SverreOK/fdcanhat/fdcanhat/fdcanhat.kicad_pcb

## KiCad design fdcanhat/fdcanhat.kicad_pcb (2026-01-27)

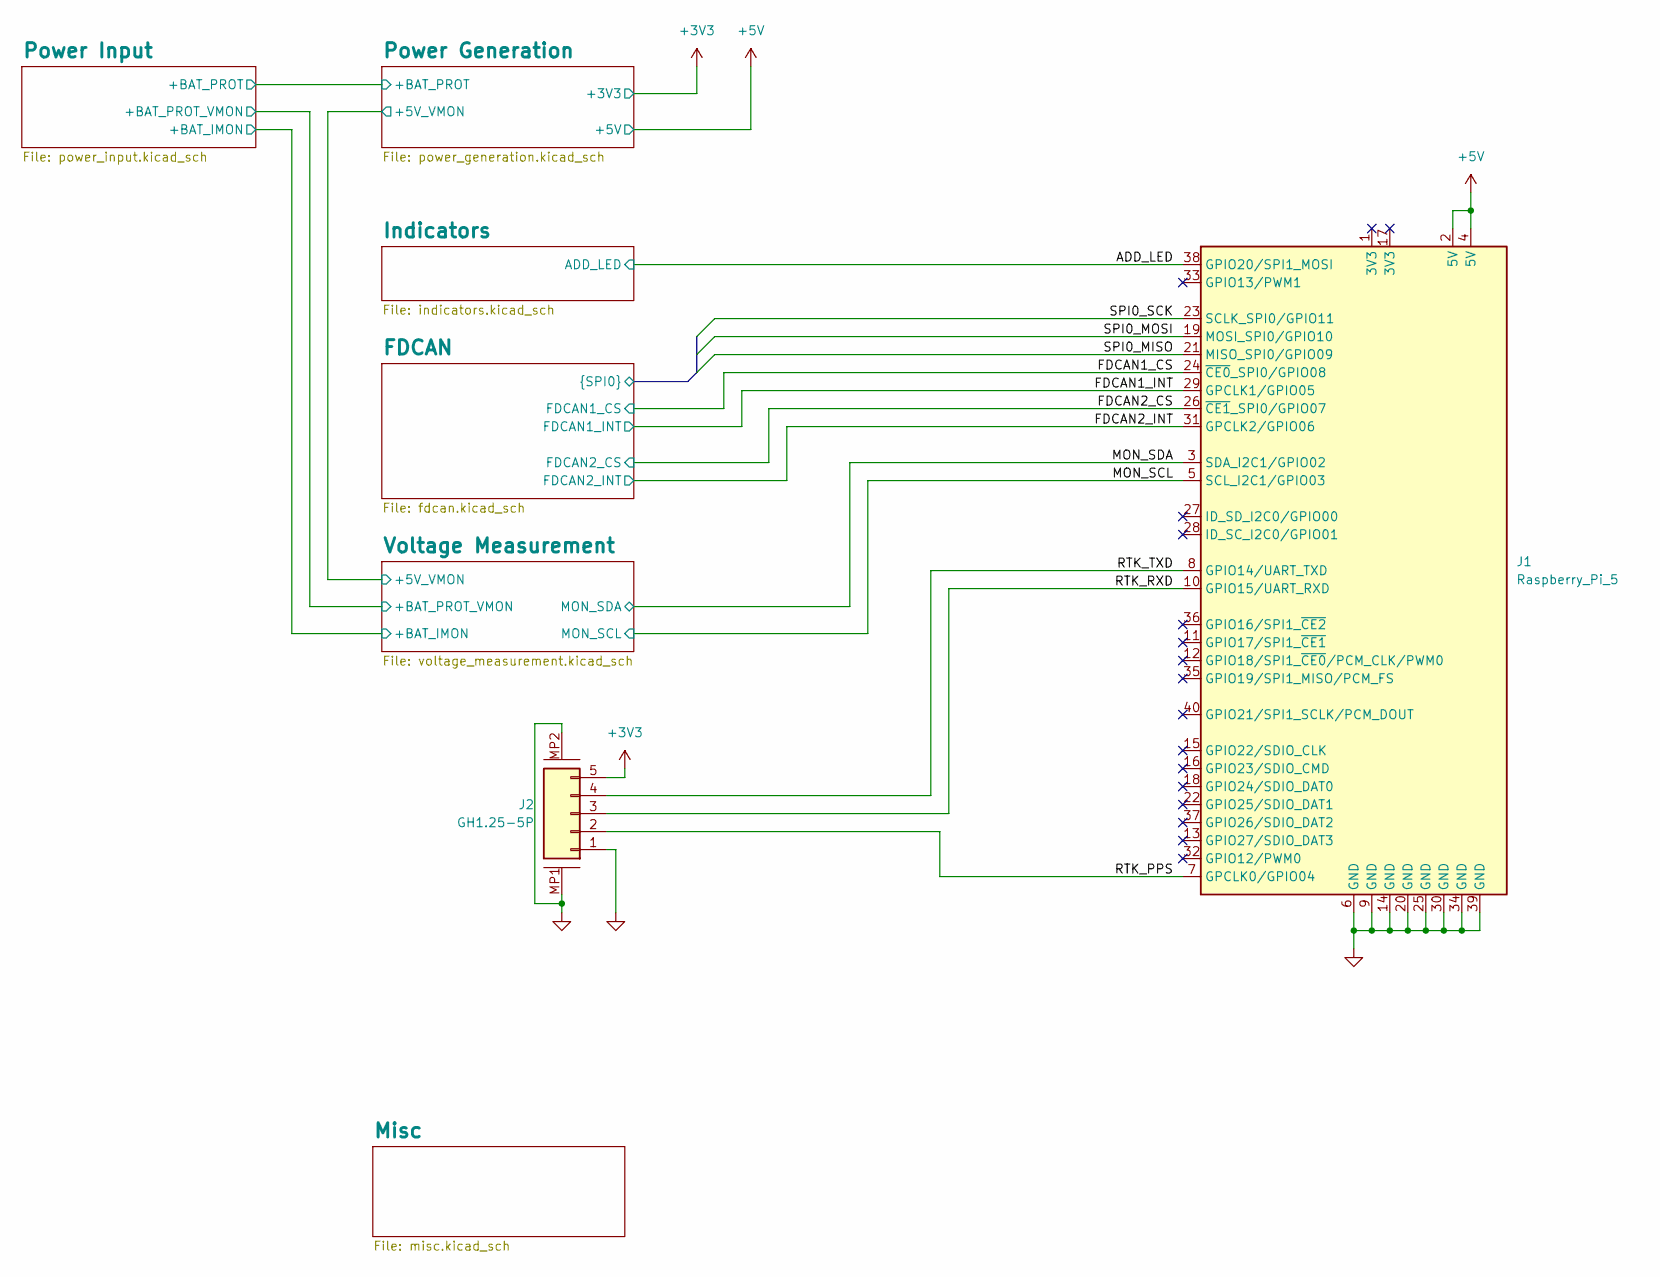
[picture p1: schematic fdcanhat.kicad_sch, Main]

Parts:
J1: Raspberry_Pi_5; PinHeader_2x20_P2.54mm_Vertical
J2: GH1.25-5P; SM05B-GHS-TB-LF-SN; LCSC C189896

Connections:
+3V3: J2.5; also elsewhere on the board
+5V: J1.2 (5V), J1.4 (5V); also elsewhere on the board
/ADD_LED: J1.38 (GPIO20/SPI1_MOSI); also elsewhere on the board
/FDCAN1_CS: J1.24 (~CE0_SPI0/GPIO08); also elsewhere on the board
/FDCAN1_INT: J1.29 (GPCLK1/GPIO05); also elsewhere on the board
/FDCAN2_CS: J1.26 (~CE1_SPI0/GPIO07); also elsewhere on the board
/FDCAN2_INT: J1.31 (GPCLK2/GPIO06); also elsewhere on the board
/FDCAN/SPI0_MISO: J1.21 (MISO_SPI0/GPIO09); also elsewhere on the board
/FDCAN/SPI0_MOSI: J1.19 (MOSI_SPI0/GPIO10); also elsewhere on the board
/FDCAN/SPI0_SCK: J1.23 (SCLK_SPI0/GPIO11); also elsewhere on the board
/MON_SCL: J1.5 (SCL_I2C1/GPIO03); also elsewhere on the board
/MON_SDA: J1.3 (SDA_I2C1/GPIO02); also elsewhere on the board
/RTK_PPS: J1.7 (GPCLK0/GPIO04), J2.2
/RTK_RXD: J1.10 (GPIO15/UART_RXD), J2.3
/RTK_TXD: J1.8 (GPIO14/UART_TXD), J2.4
GND: J1.6 (GND), J1.9 (GND), J1.14 (GND), J1.20 (GND), J1.25 (GND), J1.30 (GND), J1.34 (GND), J1.39 (GND), J2.1, J2.MP1, J2.MP2; also elsewhere on the board

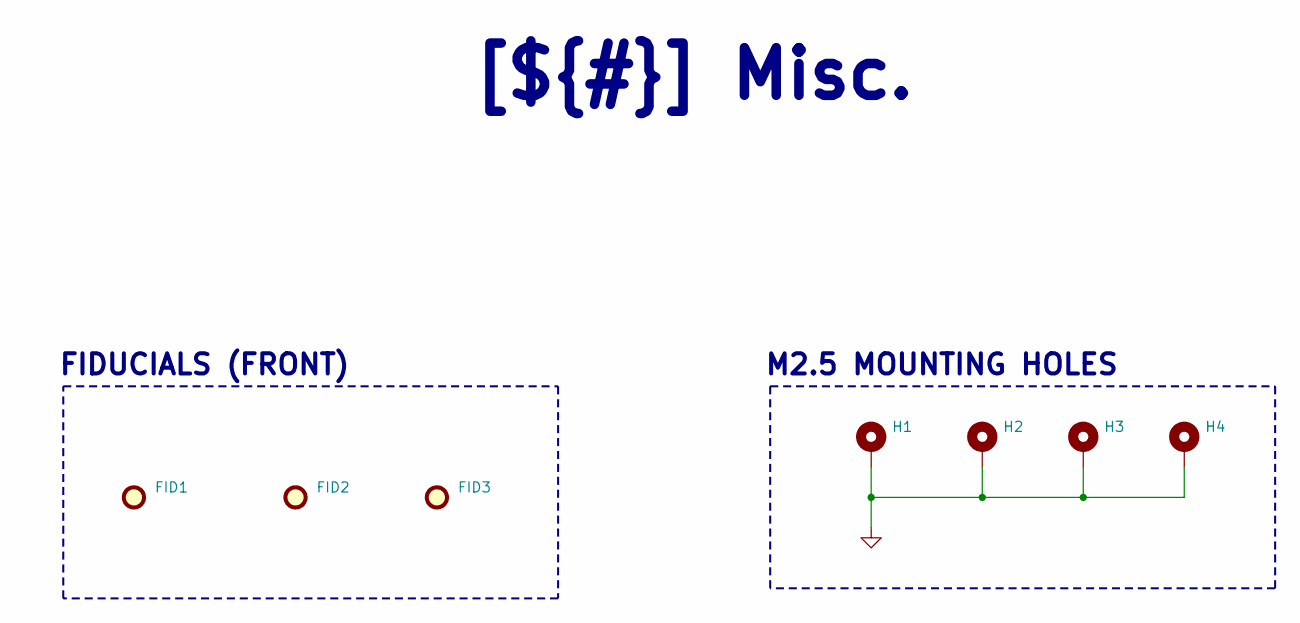
[picture p2: schematic misc.kicad_sch]

Parts:
FID1, FID2, FID3: Fiducial; Fiducial_1mm_Mask2mm
H1, H2, H3, H4: MountingHole_Pad; MountingHole_2.7mm_M2.5_Pad_Via

Connections:
GND: H1.1, H2.1, H3.1, H4.1; also elsewhere on the board

Notes on the sheet:
FIDUCIALS (FRONT)
M2.5 MOUNTING HOLES
[${#}] ${TITLE}

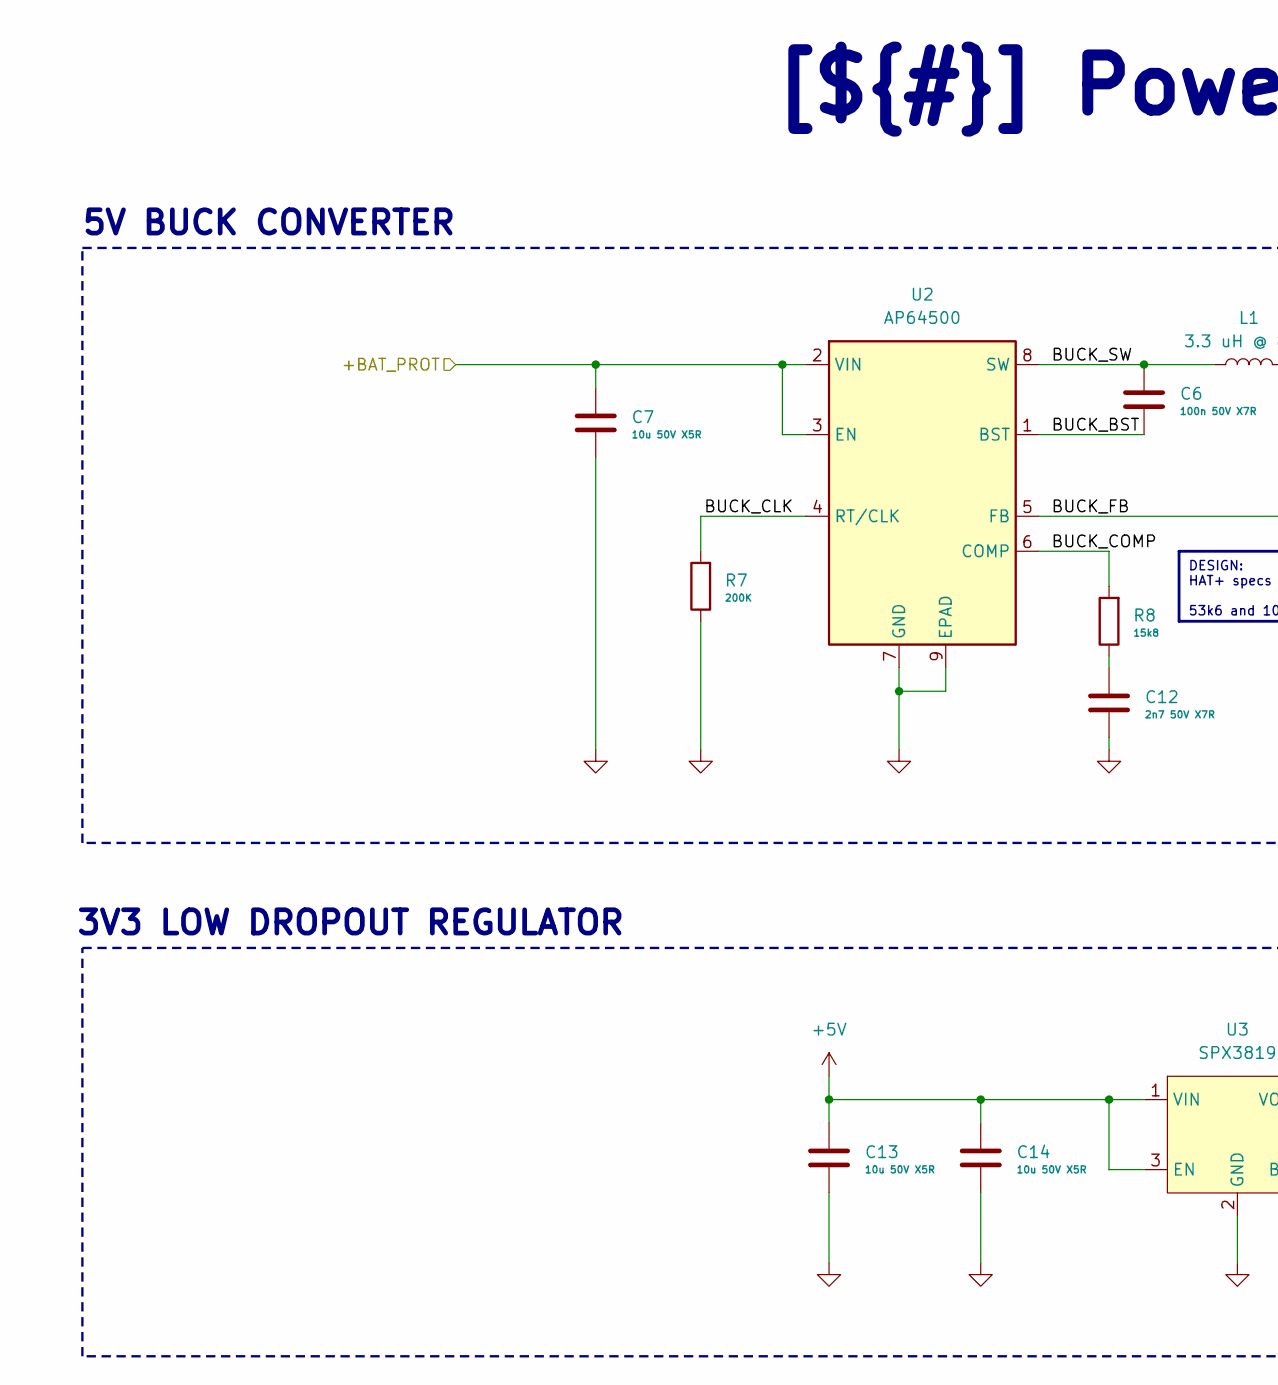
[picture p3: schematic power_generation.kicad_sch, Power Generation, part in row 1, column 1]

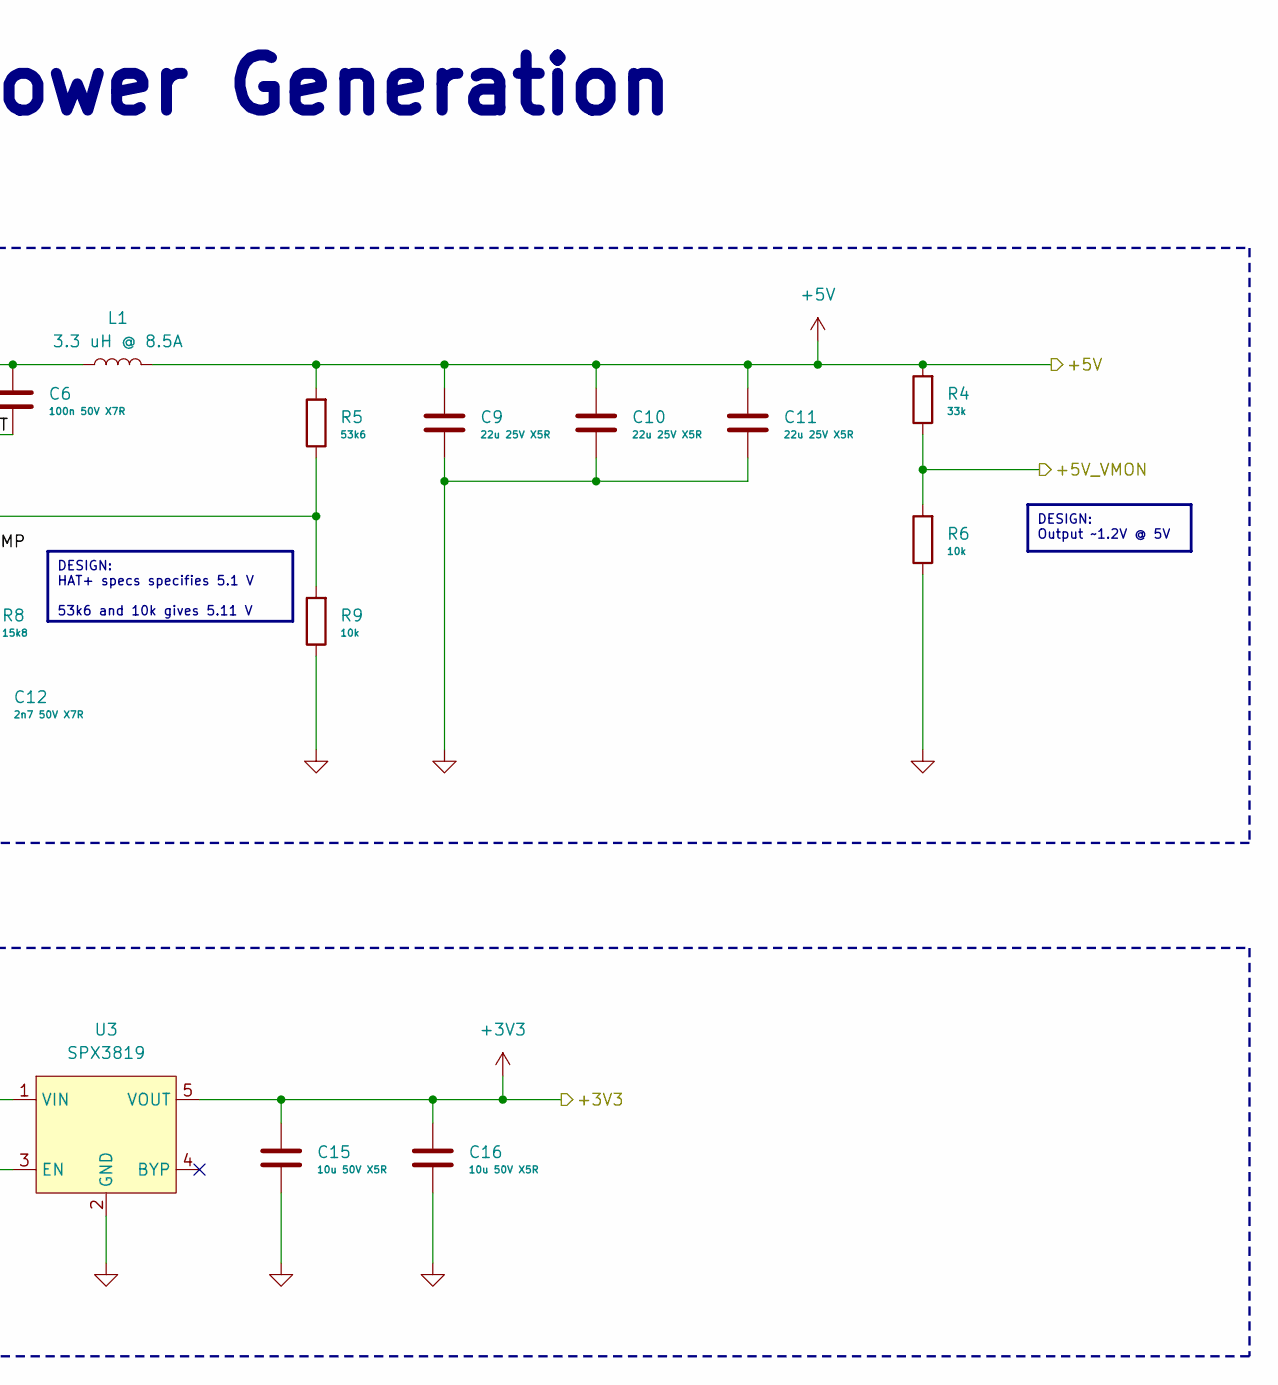
[picture p4: schematic power_generation.kicad_sch, Power Generation, part in row 1, column 2]

Parts:
C6: 100n 50V X7R; C_0402_1005Metric; LCSC C307331
C7, C13, C14, C15, C16: 10u 50V X5R; C_0805_2012Metric; LCSC C440198
C9, C10, C11: 22u 25V X5R; C_0805_2012Metric; LCSC C45783
C12: 2n7 50V X7R; C_0402_1005Metric; LCSC C106251
L1: 3.3 uH @ 8.5A; IND-SMD_L7.0-W6.6; LCSC C167219
R4: 33k; R_0402_1005Metric; LCSC C25779
R5: 53k6; R_0402_1005Metric; LCSC C53398
R6, R9: 10k; R_0402_1005Metric; LCSC C25744
R7: 200K; R_0402_1005Metric; LCSC C25764
R8: 15k8; R_0402_1005Metric; LCSC C26956
U2: AP64500; SO-8-EP; LCSC C2070920
U3: SPX3819; SOT-23-5; LCSC C9055

Connections:
+3V3: C15.1, C16.1, U3.5 (VOUT); also elsewhere on the board
+5V: C9.1, C10.1, C11.1, C13.1, C14.1, L1.2, R4.2, R5.2, U3.1 (VIN), U3.3 (EN); also elsewhere on the board
+BAT_PROT: C7.1, U2.2 (VIN), U2.3 (EN); also elsewhere on the board
/Power Generation/+5V_VMON: R4.1, R6.2; also elsewhere on the board
/Power Generation/BUCK_BST: C6.2, U2.1 (BST)
/Power Generation/BUCK_CLK: R7.2, U2.4 (RT/CLK)
/Power Generation/BUCK_COMP: R8.2, U2.6 (COMP)
/Power Generation/BUCK_FB: R5.1, R9.2, U2.5 (FB)
/Power Generation/BUCK_SW: C6.1, L1.1, U2.8 (SW)
GND: C7.2, C9.2, C10.2, C11.2, C12.2, C13.2, C14.2, C15.2, C16.2, R6.1, R7.1, R9.1, U2.7 (GND), U2.9 (EPAD), U3.2 (GND); also elsewhere on the board
unnamed: C12.1, R8.1

Notes on the sheet:
3V3 LOW DROPOUT REGULATOR
5V BUCK CONVERTER
DESIGN: Output ~1.2V @ 5V
[${#}] ${TITLE}
DESIGN: HAT+ specs specifies 5.1 V 53k6 and 10k gives 5.11 V

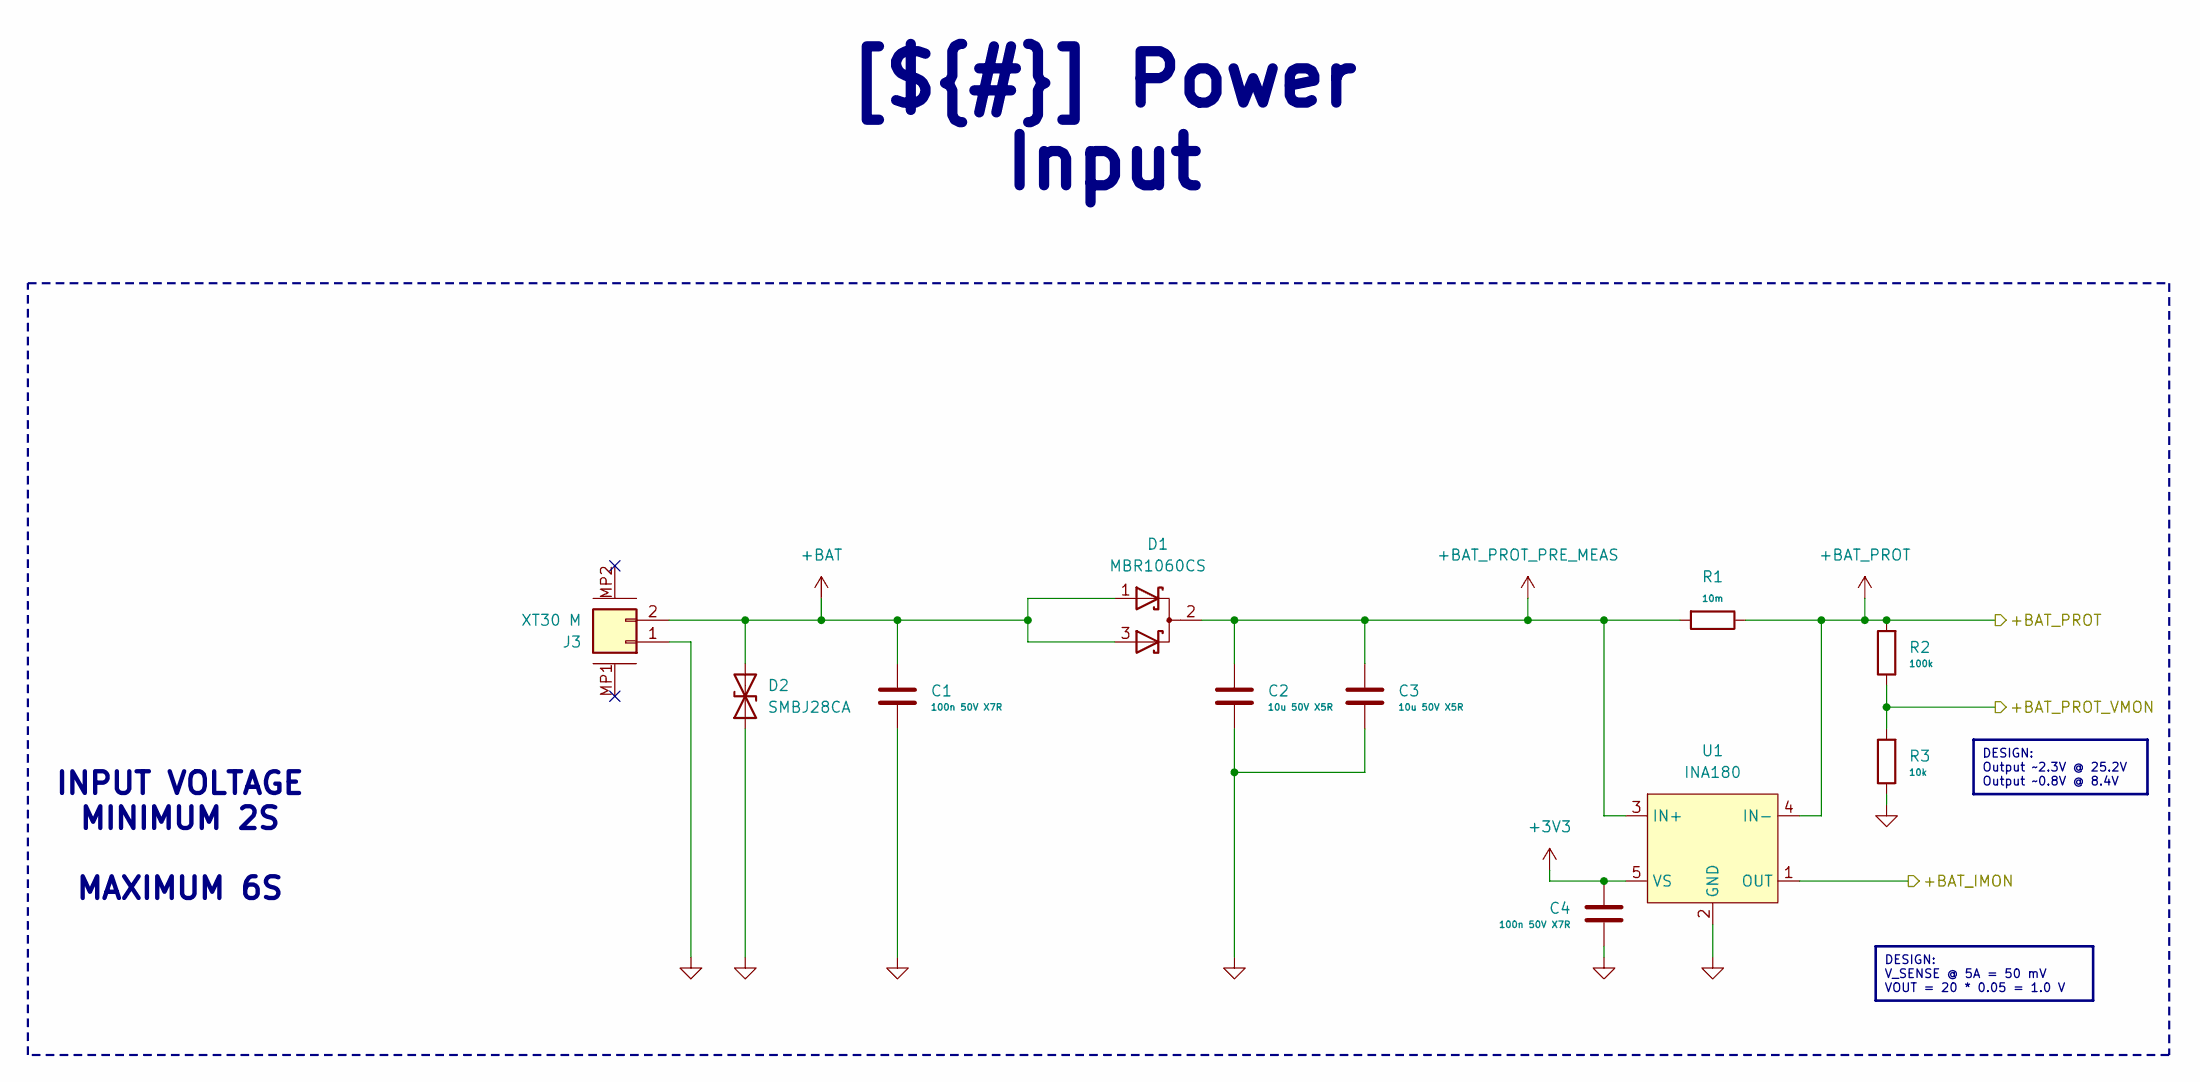
[picture p5: schematic power_input.kicad_sch, Power Input]

Parts:
C1, C4: 100n 50V X7R; C_0402_1005Metric; LCSC C307331
C2, C3: 10u 50V X5R; C_0805_2012Metric; LCSC C440198
D1: MBR1060CS; TO-252-2_L6.6-W6.1-P4.57-LS10.2-TR-CW; LCSC C5220847
D2: SMBJ28CA; D_SMB; LCSC C19077583
J3: XT30 M; XT30PW-M
R1: 10m; R_2512_6332Metric; LCSC C108943
R2: 100k; R_0402_1005Metric; LCSC C25741
R3: 10k; R_0402_1005Metric; LCSC C25744
U1: INA180; SOT-23-5; LCSC C122228

Connections:
+3V3: C4.2, U1.5 (VS); also elsewhere on the board
+BAT: C1.1, D1.1 (A), D1.3 (A), D2.2 (A2), J3.2
+BAT_PROT: R1.1, R2.2, U1.4 (IN-); also elsewhere on the board
+BAT_PROT_PRE_MEAS: C2.1, C3.1, D1.2 (K), R1.2, U1.3 (IN+)
/Power Input/+BAT_IMON: U1.1 (OUT); also elsewhere on the board
/Power Input/+BAT_PROT_VMON: R2.1, R3.2; also elsewhere on the board
GND: C1.2, C2.2, C3.2, C4.1, D2.1 (A1), J3.1, R3.1, U1.2 (GND); also elsewhere on the board

Notes on the sheet:
INPUT VOLTAGE MINIMUM 2S MAXIMUM 6S
DESIGN: Output ~2.3V @ 25.2V Output ~0.8V @ 8.4V
[${#}] ${TITLE}
DESIGN: V_SENSE @ 5A = 50 mV VOUT = 20 * 0.05 = 1.0 V

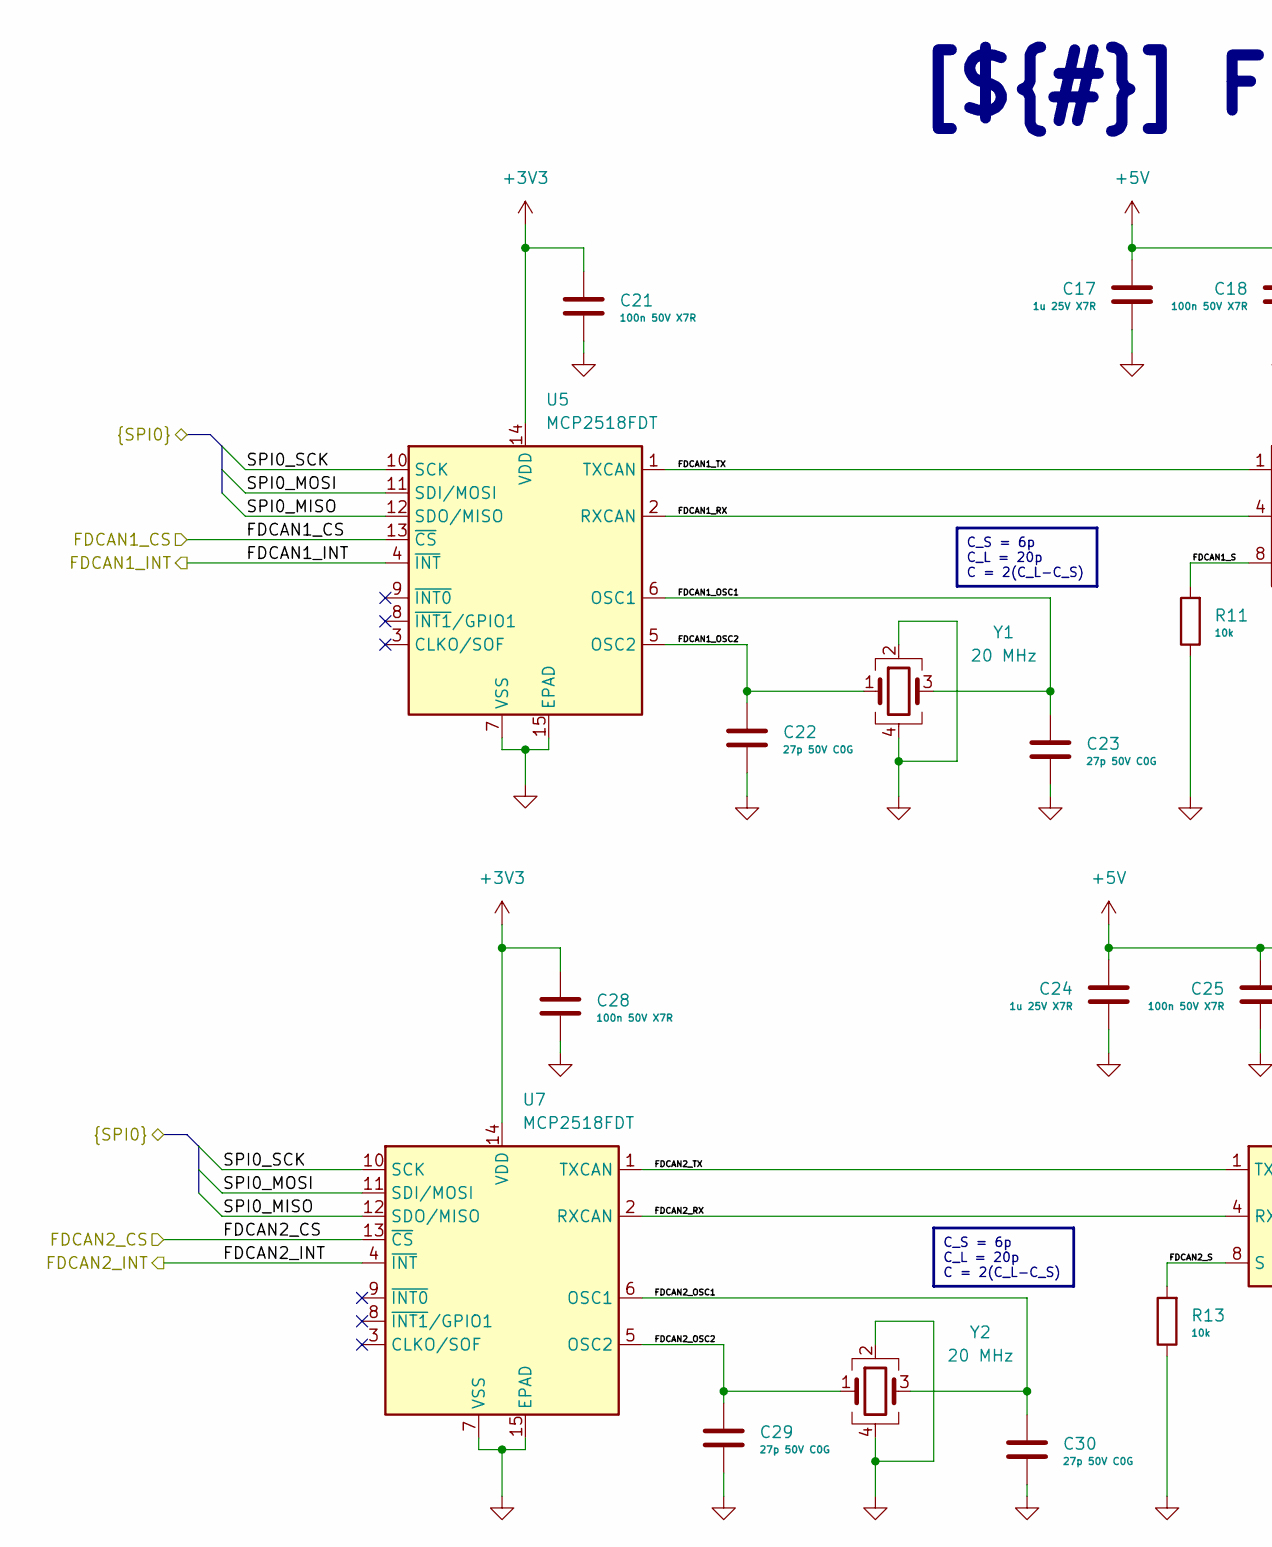
[picture p6: schematic fdcan.kicad_sch, part in row 1, column 1]

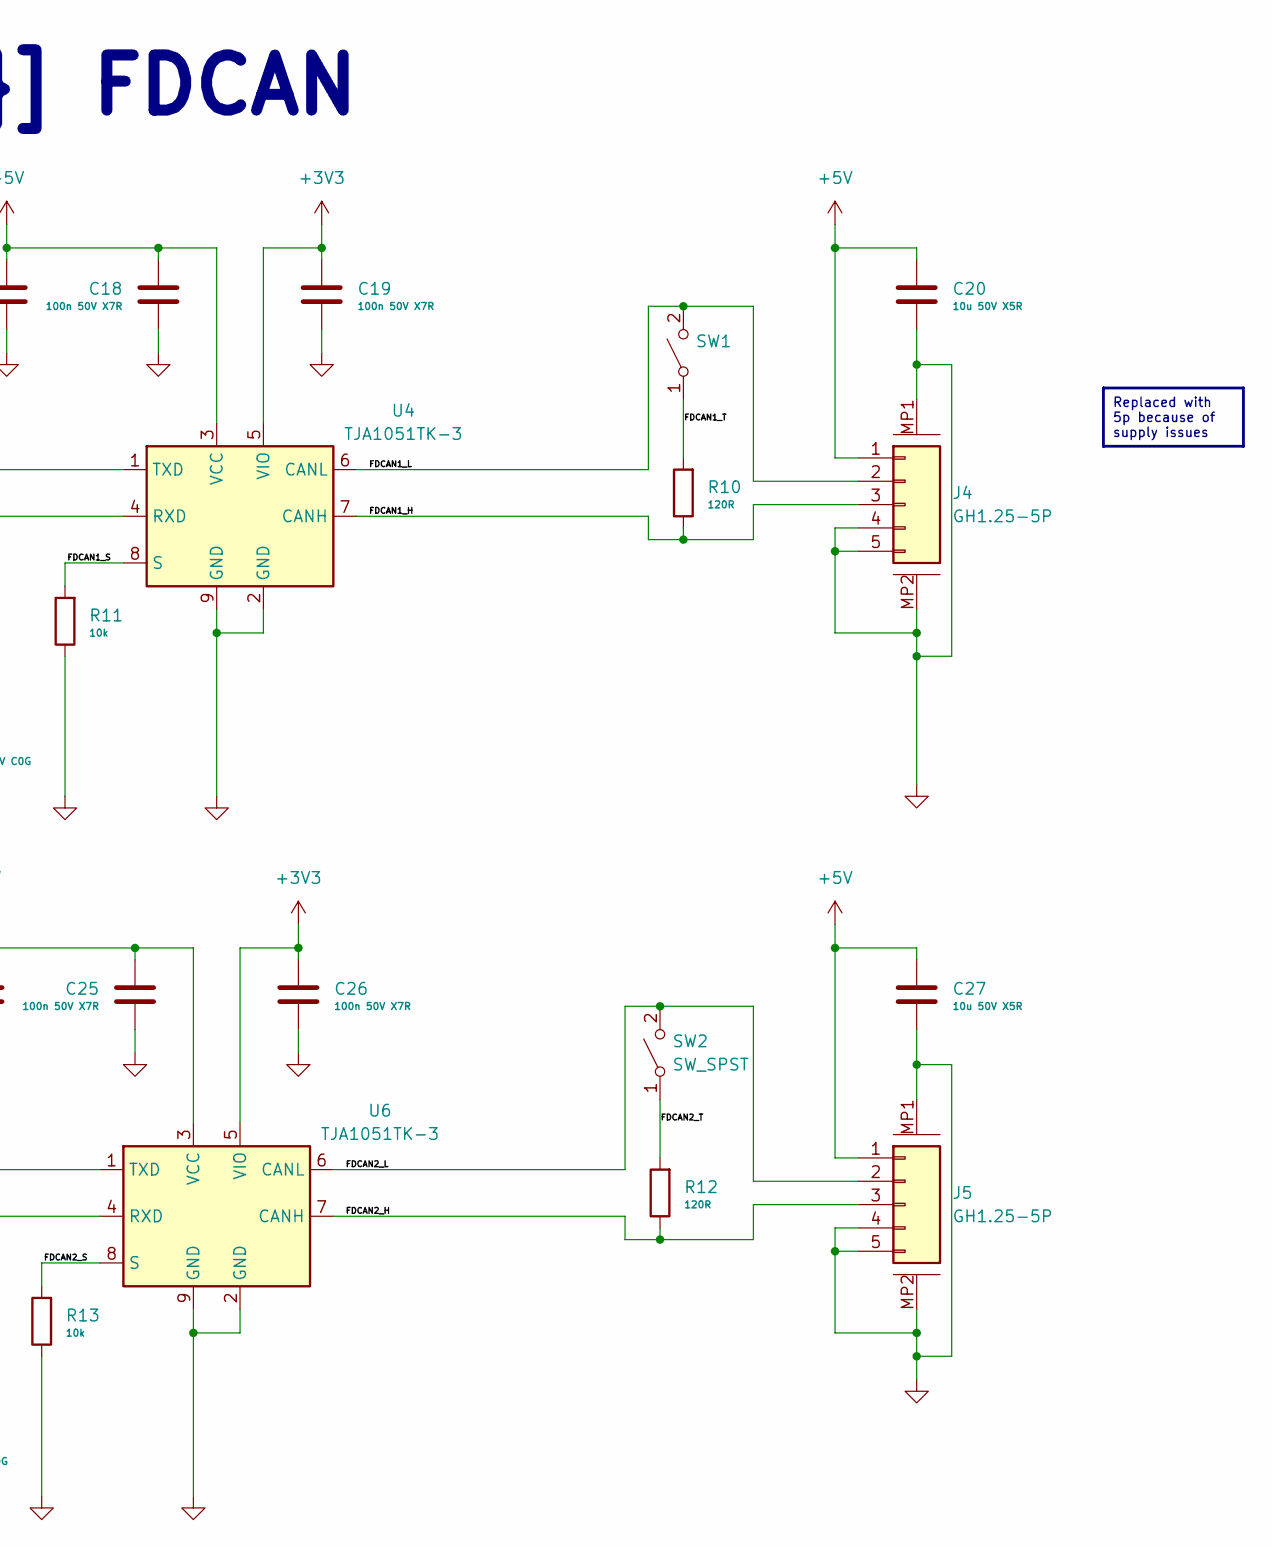
[picture p7: schematic fdcan.kicad_sch, part in row 1, column 2]

Parts:
C17, C24: 1u 25V X7R; C_0402_1005Metric; LCSC C52923
C18, C19, C21, C25, C26, C28: 100n 50V X7R; C_0402_1005Metric; LCSC C307331
C20, C27: 10u 50V X5R; C_0805_2012Metric; LCSC C440198
C22, C23, C29, C30: 27p 50V C0G; C_0402_1005Metric; LCSC C3889037
J4, J5: GH1.25-5P; SM05B-GHS-TB-LF-SN; LCSC C189896
R10, R12: 120R; R_0805_2012Metric; LCSC C17437
R11, R13: 10k; R_0402_1005Metric; LCSC C25744
SW1, SW2: SW_SPST; SW-SMD_DSIC01LSGET; LCSC C54948
U4, U6: TJA1051TK-3; HVSON-8-1EP_3x3mm_P0.65mm_EP1.6x2.4mm; LCSC C2875699
U5, U7: MCP2518FDT; DFN-14-1EP_3x4.5mm_P0.65mm_EP1.65x4.25mm; LCSC C621395
Y1, Y2: 20 MHz; CRYSTAL-SMD_4P-L3.2-W2.5-BL-2; LCSC C9004

Connections:
+3V3: C19.1, C21.1, C26.1, C28.1, U4.5 (VIO), U5.14 (VDD), U6.5 (VIO), U7.14 (VDD); also elsewhere on the board
+5V: C17.1, C18.1, C20.1, C24.1, C25.1, C27.1, J4.1, J5.1, U4.3 (VCC), U6.3 (VCC); also elsewhere on the board
/FDCAN1_CS: U5.13 (~CS); also elsewhere on the board
/FDCAN1_INT: U5.4 (~INT); also elsewhere on the board
/FDCAN2_CS: U7.13 (~CS); also elsewhere on the board
/FDCAN2_INT: U7.4 (~INT); also elsewhere on the board
/FDCAN/FDCAN1_H: J4.3, R10.1, U4.7 (CANH)
/FDCAN/FDCAN1_L: J4.2, SW1.2 (B), U4.6 (CANL)
/FDCAN/FDCAN1_OSC1: C23.1, U5.6 (OSC1), Y1.3
/FDCAN/FDCAN1_OSC2: C22.1, U5.5 (OSC2), Y1.1
/FDCAN/FDCAN1_RX: U4.4 (RXD), U5.2 (RXCAN)
/FDCAN/FDCAN1_S: R11.2, U4.8 (S)
/FDCAN/FDCAN1_T: R10.2, SW1.1 (A)
/FDCAN/FDCAN1_TX: U4.1 (TXD), U5.1 (TXCAN)
/FDCAN/FDCAN2_H: J5.3, R12.1, U6.7 (CANH)
/FDCAN/FDCAN2_L: J5.2, SW2.2 (B), U6.6 (CANL)
/FDCAN/FDCAN2_OSC1: C30.1, U7.6 (OSC1), Y2.3
/FDCAN/FDCAN2_OSC2: C29.1, U7.5 (OSC2), Y2.1
/FDCAN/FDCAN2_RX: U6.4 (RXD), U7.2 (RXCAN)
/FDCAN/FDCAN2_S: R13.2, U6.8 (S)
/FDCAN/FDCAN2_T: R12.2, SW2.1 (A)
/FDCAN/FDCAN2_TX: U6.1 (TXD), U7.1 (TXCAN)
/FDCAN/SPI0_MISO: U5.12 (SDO/MISO), U7.12 (SDO/MISO); also elsewhere on the board
/FDCAN/SPI0_MOSI: U5.11 (SDI/MOSI), U7.11 (SDI/MOSI); also elsewhere on the board
/FDCAN/SPI0_SCK: U5.10 (SCK), U7.10 (SCK); also elsewhere on the board
GND: C17.2, C18.2, C19.2, C20.2, C21.2, C22.2, C23.2, C24.2, C25.2, C26.2, C27.2, C28.2, C29.2, C30.2, J4.4, J4.5, J4.MP1, J4.MP2, J5.4, J5.5, J5.MP1, J5.MP2, R11.1, R13.1, U4.2 (GND), U4.9 (GND), U5.7 (VSS), U5.15 (EPAD), U6.2 (GND), U6.9 (GND), U7.7 (VSS), U7.15 (EPAD), Y1.2, Y1.4, Y2.2, Y2.4; also elsewhere on the board

Notes on the sheet:
C_S = 6p C_L = 20p C = 2(C_L-C_S)
Replaced with 5p because of supply issues
[${#}] ${TITLE}

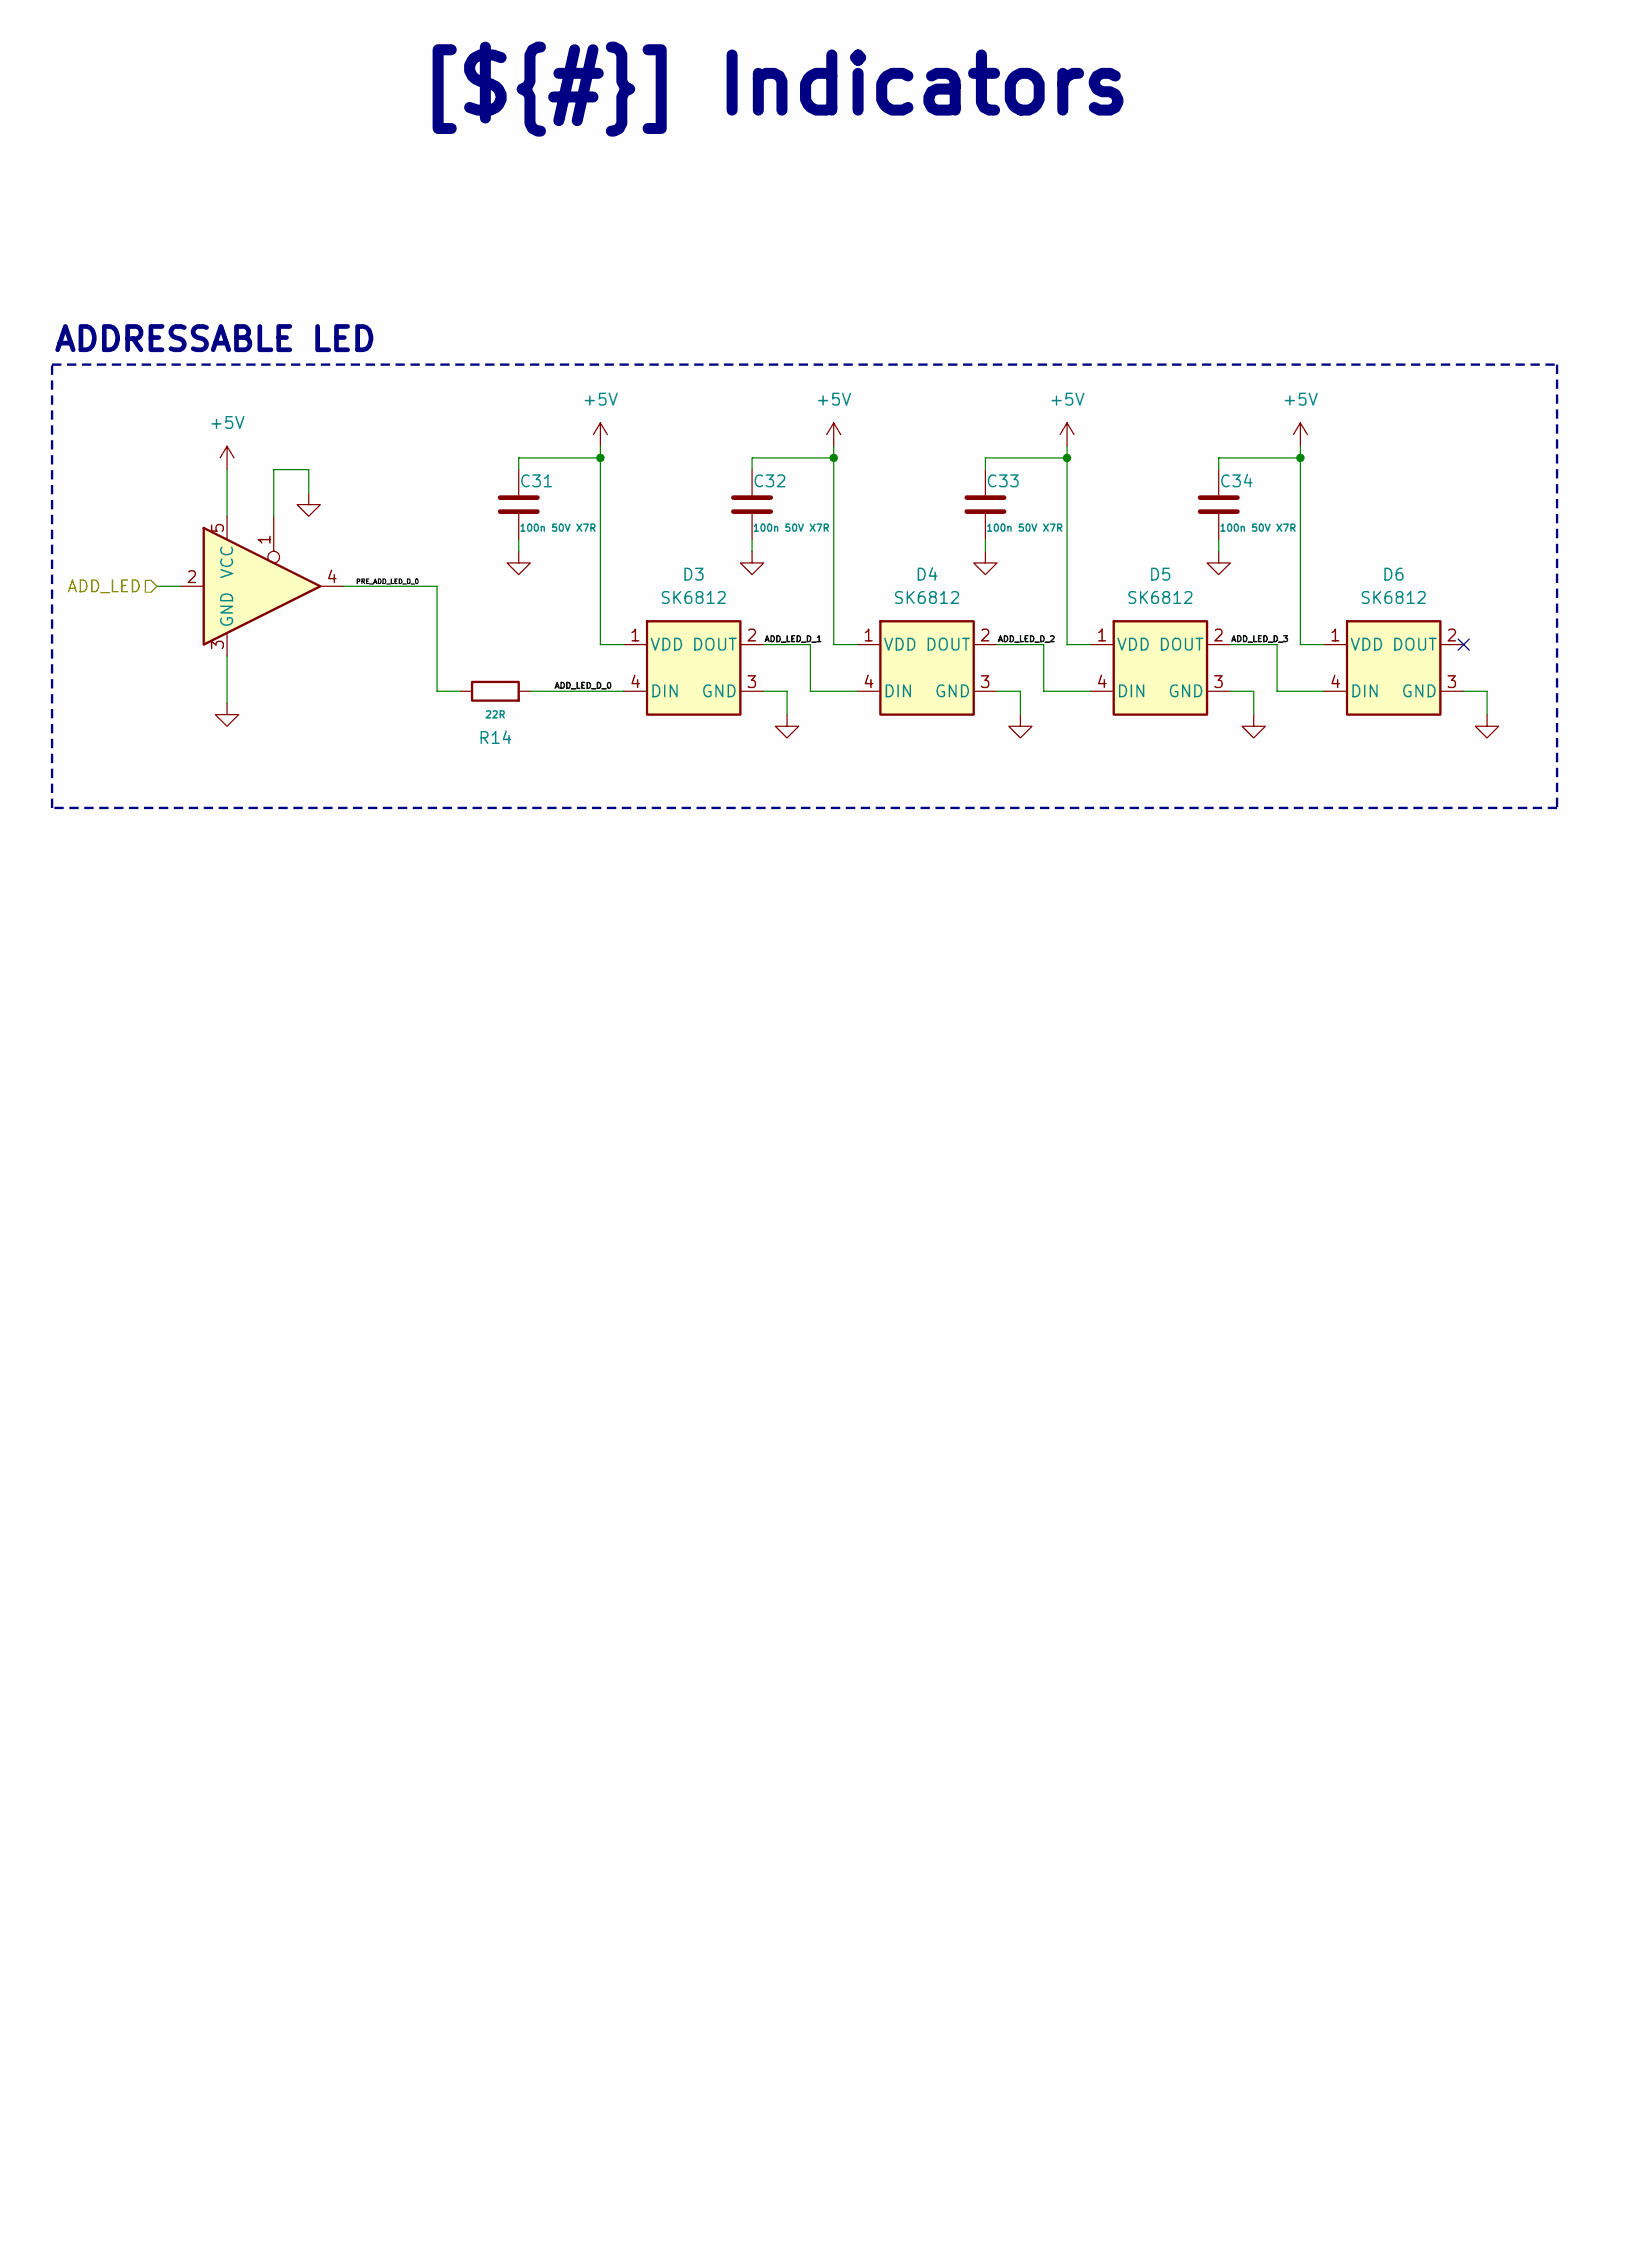
[picture p8: schematic indicators.kicad_sch, part in row 1, column 1]

Parts:
C31, C32, C33, C34: 100n 50V X7R; C_0402_1005Metric; LCSC C307331
D3, D4, D5, D6: SK6812; LED-SMD_4P-L2.0-W2.0-BR; LCSC C2909058
R14: 22R; R_0402_1005Metric; LCSC C25092
U8: 74AHCT1G125; SOT-23-5; LCSC C20617903

Connections:
+5V: C31.1, C32.1, C33.1, C34.1, D3.1 (VDD), D4.1 (VDD), D5.1 (VDD), D6.1 (VDD), U8.5 (VCC); also elsewhere on the board
/ADD_LED: U8.2; also elsewhere on the board
/Indicators/ADD_LED_D_0: D3.4 (DIN), R14.2
/Indicators/ADD_LED_D_1: D3.2 (DOUT), D4.4 (DIN)
/Indicators/ADD_LED_D_2: D4.2 (DOUT), D5.4 (DIN)
/Indicators/ADD_LED_D_3: D5.2 (DOUT), D6.4 (DIN)
/Indicators/PRE_ADD_LED_D_0: R14.1, U8.4
GND: C31.2, C32.2, C33.2, C34.2, D3.3 (GND), D4.3 (GND), D5.3 (GND), D6.3 (GND), U8.1, U8.3 (GND); also elsewhere on the board

Notes on the sheet:
ADDRESSABLE LED
[${#}] ${TITLE}

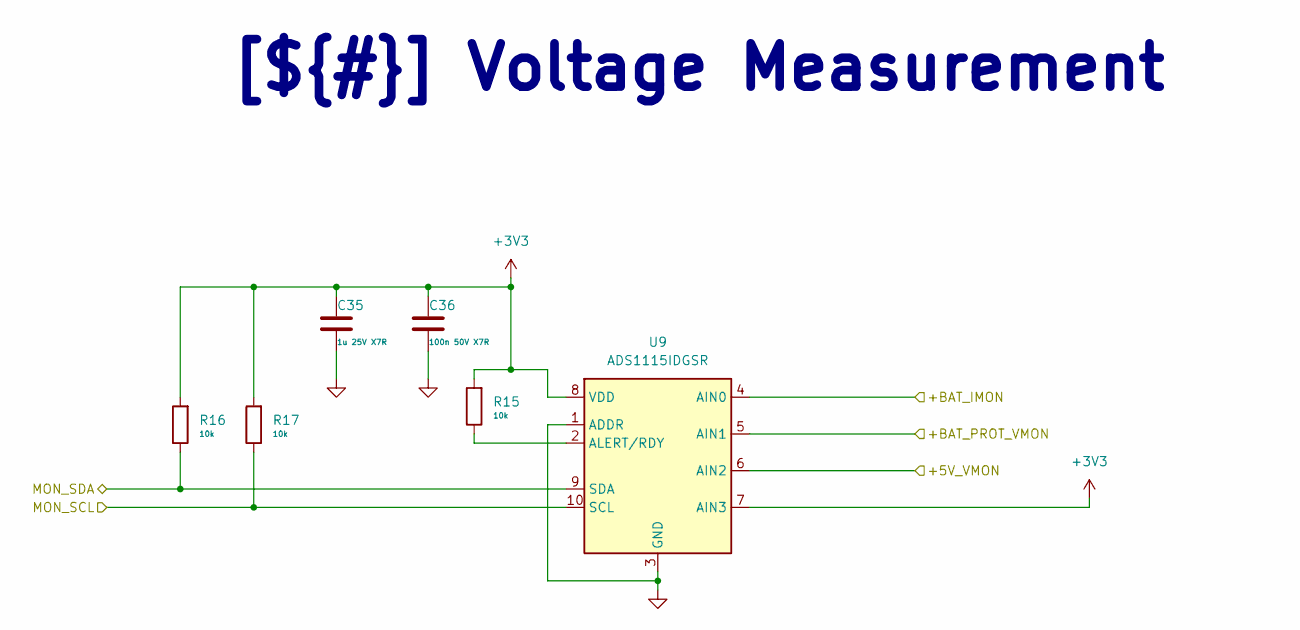
[picture p9: schematic voltage_measurement.kicad_sch, Voltage Measurement]

Parts:
C35: 1u 25V X7R; C_0402_1005Metric; LCSC C52923
C36: 100n 50V X7R; C_0402_1005Metric; LCSC C307331
R15, R16, R17: 10k; R_0402_1005Metric; LCSC C25744
U9: ADS1115IDGSR; VSSOP-10_3x3mm_P0.5mm; LCSC C37593

Connections:
+3V3: C35.1, C36.1, R15.2, R16.2, R17.2, U9.7 (AIN3), U9.8 (VDD); also elsewhere on the board
/MON_SCL: R17.1, U9.10 (SCL); also elsewhere on the board
/MON_SDA: R16.1, U9.9 (SDA); also elsewhere on the board
/Power Generation/+5V_VMON: U9.6 (AIN2); also elsewhere on the board
/Power Input/+BAT_IMON: U9.4 (AIN0); also elsewhere on the board
/Power Input/+BAT_PROT_VMON: U9.5 (AIN1); also elsewhere on the board
GND: C35.2, C36.2, U9.1 (ADDR), U9.3 (GND); also elsewhere on the board
unnamed: R15.1, U9.2 (ALERT/RDY)

Notes on the sheet:
[${#}] ${TITLE}
