SverreOK/fdcanhat/fdcanhat/fdcanhat.kicad_pcb

## KiCad design fdcanhat/fdcanhat.kicad_pcb (continued)

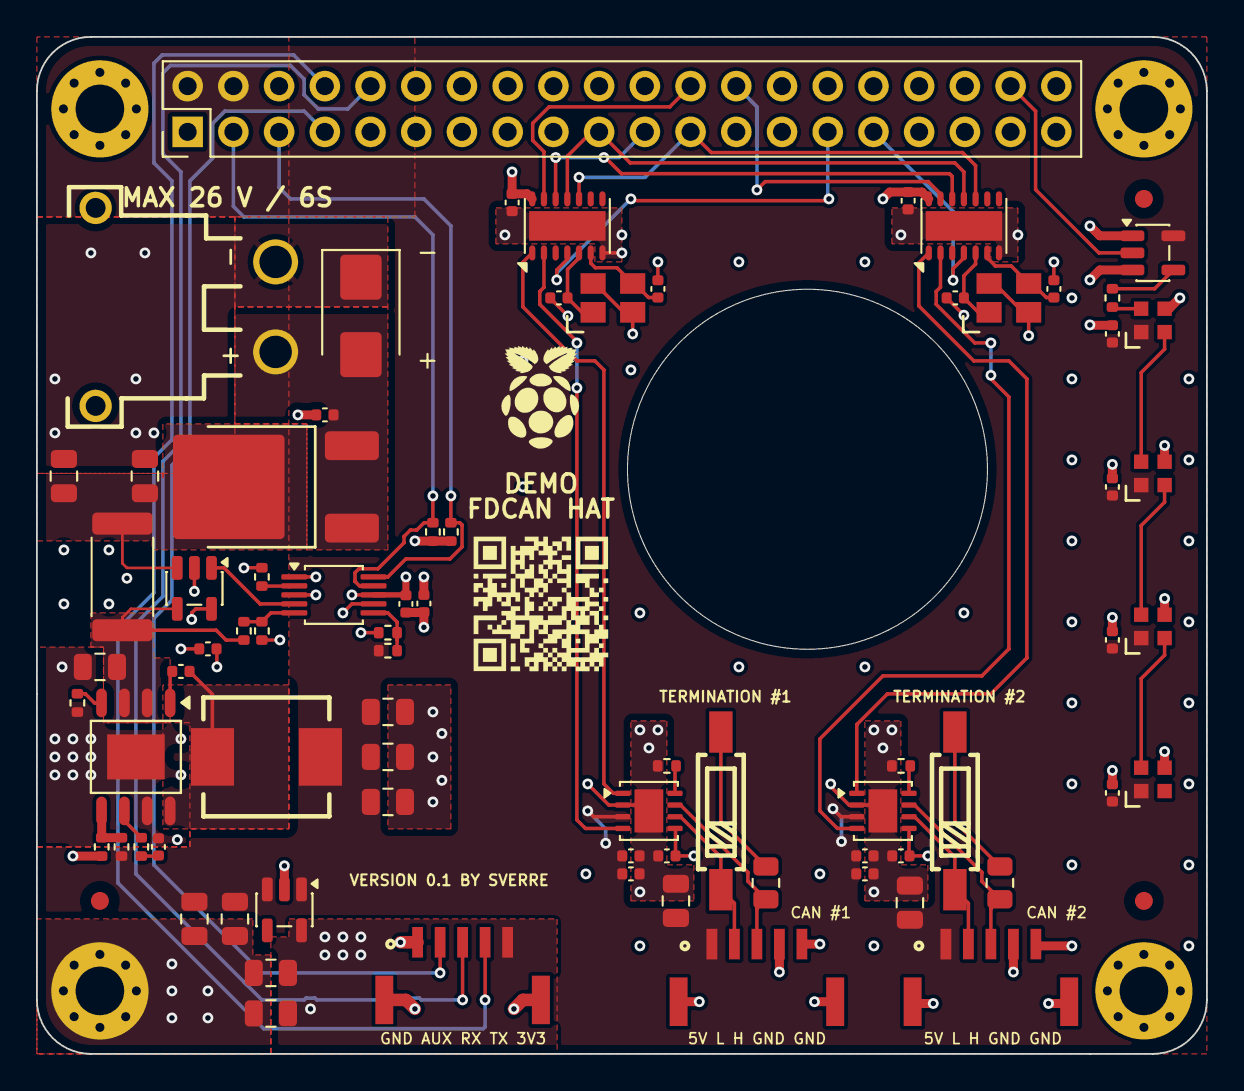
[picture p10: board fdcanhat.kicad_pcb from above]

Board: 4 copper layers, 65.0 x 56.5 mm, 83 parts (0 on the bottom side), 50 nets.
