SverreOK/fdcanhat/(commit log)

2026-01-08 ish done with schematics
    [eeprom.kicad_sch, fdcan.kicad_sch, fdcanhat.kicad_pcb, fdcanhat.kicad_sch, indicators.kicad_sch, misc.kicad_sch, power_generation.kicad_sch, power_input.kicad_sch]
2026-01-09 board layout done, ready for routing
    [eeprom.kicad_sch, fdcan.kicad_sch, fdcanhat.kicad_pcb, fdcanhat.kicad_sch, indicators.kicad_sch, misc.kicad_sch, power_generation.kicad_sch, power_input.kicad_sch]
2026-01-15 almost done
    [BOM-fdcanhat.csv, fdcan.kicad_sch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]
2026-01-16 done doublechecking, going for review
    [BOM-fdcanhat.csv, fdcan.kicad_sch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]
2026-01-19 ready for last scrut
    [fdcanhat.kicad_pcb, misc.kicad_sch, power_generation.kicad_sch, power_input.kicad_sch, voltage_measurement.kicad_sch]
2026-01-27 sent to production
    [BOM-fdcanhat.csv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]
